canique/canique/mk2/Readme.MD

# Canique MK2 Schematics

These are schematics for Canique MK2 rev4 based on https://github.com/LowPowerLab/Moteino/tree/master/R4 from Felix Rusu.
Some noteable changes on the MK2 board are: The RFM69 has additional capacitors on the back of the board, the trace routing is different, the FTDI connector circumvents the voltage regulator.

# License
CC-BY-SA 4.0 https://creativecommons.org/licenses/by-sa/4.0/
You are free to share and adapt. But you need to give attribution and use the same license to redistribute.
