canique/canique/mk2/CaniqueMK2-rev4.brd

## EAGLE design mk2/CaniqueMK2-rev4.brd (2023-02-22)

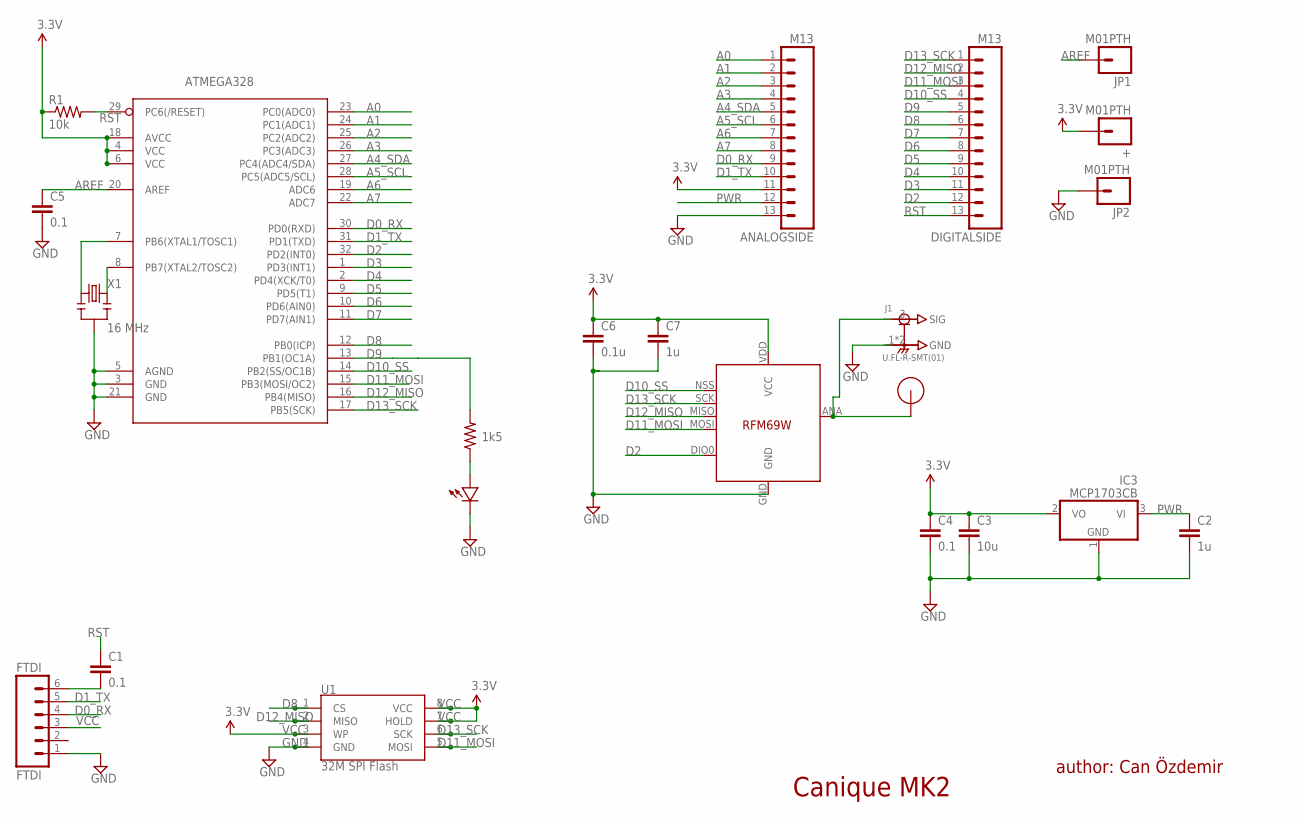
[picture p1: schematic CaniqueMK2-rev4.sch]

Parts:
+: M01PTH; 1X01
ANALOGSIDE: M13; 1X13
ATMEGA328: ATMega-328; TQFP32-08
C1, C4, C5: 0.1; 0603-CAP
C2, C7: 1u; 0603-CAP
C3: 10u; 0805-CAP
C6: 0.1u; 0603-CAP
DIGITALSIDE: M13; 1X13
FTDI: FTDI; 1X06
IC3: MCP1703CB; SOT23
J1: U.FL-R-SMT(01); HRS_U.FL-R-SMT(01)
JP1, JP2: M01PTH; 1X01
R1: 10k; 0603-RES
R2: 1k5; 0603-RES
U1: 32M SPI Flash; SO08
U$1: RFM12B_ANTENNA; RFM12B-ANTENNA
U$2: LED0603; 0603-LED
U$5: RFM69; RFM69W-MINPADS
X1: 16 MHz; RESONATOR-SMD

Connections:
A0: ANALOGSIDE.1, ATMEGA328.23 (PC0(ADC0))
A1: ANALOGSIDE.2, ATMEGA328.24 (PC1(ADC1))
A2: ANALOGSIDE.3, ATMEGA328.25 (PC2(ADC2))
A3: ANALOGSIDE.4, ATMEGA328.26 (PC3(ADC3))
A4_SDA: ANALOGSIDE.5, ATMEGA328.27 (PC4(ADC4/SDA))
A5_SCL: ANALOGSIDE.6, ATMEGA328.28 (PC5(ADC5/SCL))
A6: ANALOGSIDE.7, ATMEGA328.19 (ADC6)
A7: ANALOGSIDE.8, ATMEGA328.22 (ADC7)
AREF: ATMEGA328.20 (AREF), C5.1, JP1.1
D0_RX: ANALOGSIDE.9, ATMEGA328.30 (PD0(RXD)), FTDI.4
D1_TX: ANALOGSIDE.10, ATMEGA328.31 (PD1(TXD)), FTDI.5
D2: ATMEGA328.32 (PD2(INT0)), DIGITALSIDE.12, U$5.DIO0
D3: ATMEGA328.1 (PD3(INT1)), DIGITALSIDE.11
D4: ATMEGA328.2 (PD4(XCK/T0)), DIGITALSIDE.10
D5: ATMEGA328.9 (PD5(T1)), DIGITALSIDE.9
D6: ATMEGA328.10 (PD6(AIN0)), DIGITALSIDE.8
D7: ATMEGA328.11 (PD7(AIN1)), DIGITALSIDE.7
D8: ATMEGA328.12 (PB0(ICP)), DIGITALSIDE.6, U1.1 (CS)
D9: ATMEGA328.13 (PB1(OC1A)), DIGITALSIDE.5, R2.2
D10_SS: ATMEGA328.14 (PB2(SS/OC1B)), DIGITALSIDE.4, U$5.NSS (SEL)
D11_MOSI: ATMEGA328.15 (PB3(MOSI/OC2)), DIGITALSIDE.3, U1.5 (MOSI), U$5.MOSI
D12_MISO: ATMEGA328.16 (PB4(MISO)), DIGITALSIDE.2, U1.2 (MISO), U$5.MISO
D13_SCK: ATMEGA328.17 (PB5(SCK)), DIGITALSIDE.1, U1.6 (SCK), U$5.SCK
GND: ANALOGSIDE.13, ATMEGA328.3 (GND), ATMEGA328.5 (AGND), ATMEGA328.21 (GND), C2.2, C3.2, C4.2, C5.2, C6.2, C7.2, FTDI.1, IC3.1 (GND), J1.1 (GND), J1.2 (GND), JP2.1, U1.4 (GND), U$2.MINUS, U$5.GND, X1.2
unnamed: ATMEGA328.7 (PB6(XTAL1/TOSC1)), X1.1
unnamed: R2.1, U$2.PLUS
unnamed: J1.3 (SIG), U$1.P$1, U$5.ANA (ANT)
unnamed: C1.2, FTDI.6
unnamed: ATMEGA328.8 (PB7(XTAL2/TOSC2)), X1.3
PWR: ANALOGSIDE.12, C2.1, IC3.3 (VI)
RST: ATMEGA328.29 (PC6(/RESET)), C1.1, DIGITALSIDE.13, R1.2
VCC: +.1, ANALOGSIDE.11, ATMEGA328.4 (VCC), ATMEGA328.6 (VCC), ATMEGA328.18 (AVCC), C3.1, C4.1, C6.1, C7.1, FTDI.3, IC3.2 (VO), R1.1, U1.3 (WP), U1.7 (HOLD), U1.8 (VCC), U$5.VDD (VCC)

Notes on the sheet:
Canique MK2
author: Can Özdemir

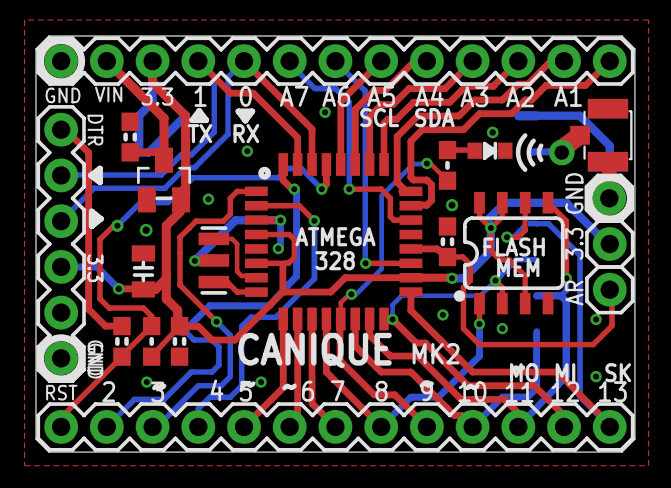
[picture p2: board CaniqueMK2-rev4.brd from above]

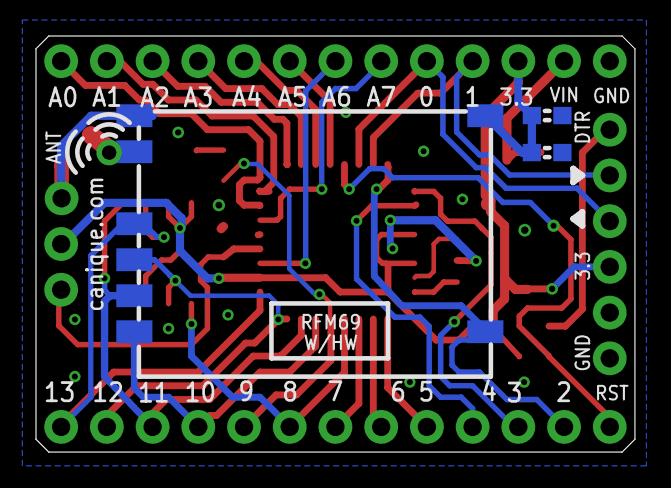
[picture p3: board CaniqueMK2-rev4.brd from below]

Board: 2 copper layers, 33.3 x 23.1 mm, 23 parts (3 on the bottom side), 32 nets.
