canique/canique/(commit log)

2018-02-03 Create battery_measurement.ino
    Used to demonstrate how to measure battery voltage with a Canique ULV board.
2018-02-04 Update battery_measurement.ino
    added comment
2018-02-04 Update battery_measurement.ino
    fixed error with BATTERY_VOLTAGE_PRESCALER
    put a delay after switching voltage reference
    discard readings that are interrupted by any other interrupt than the ADC interrupt
    [battery_measurement.ino]
2018-02-28 Update battery_measurement.ino
    Fixed power consumption issues with ADC in low power mode.
    [battery_measurement.ino]
2023-02-22 mk2 rev4 schematics
    [CaniqueMK2-rev4.brd, CaniqueMK2-rev4.sch]
